bernathtamas/KG-cso-tarto/assets/video-poster.jpg

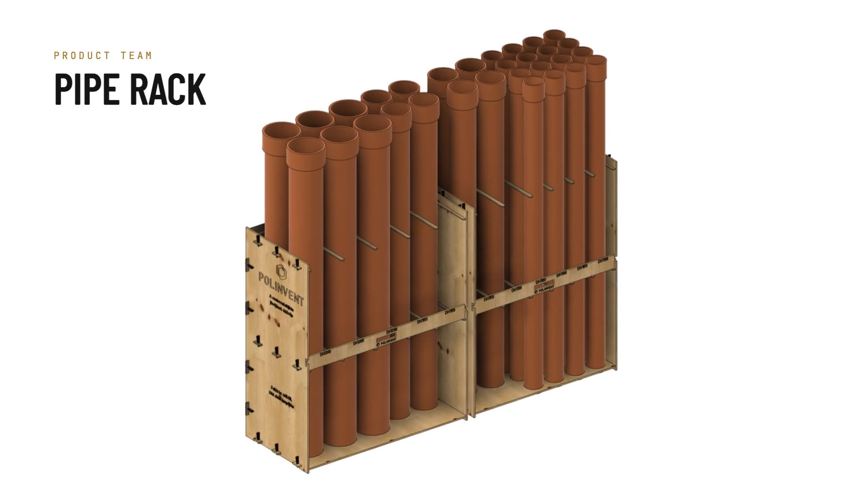
assets/video-poster.jpg
