bernathtamas/KG-cso-tarto/assets/kepek/reszlet_fesu_ek.jpg

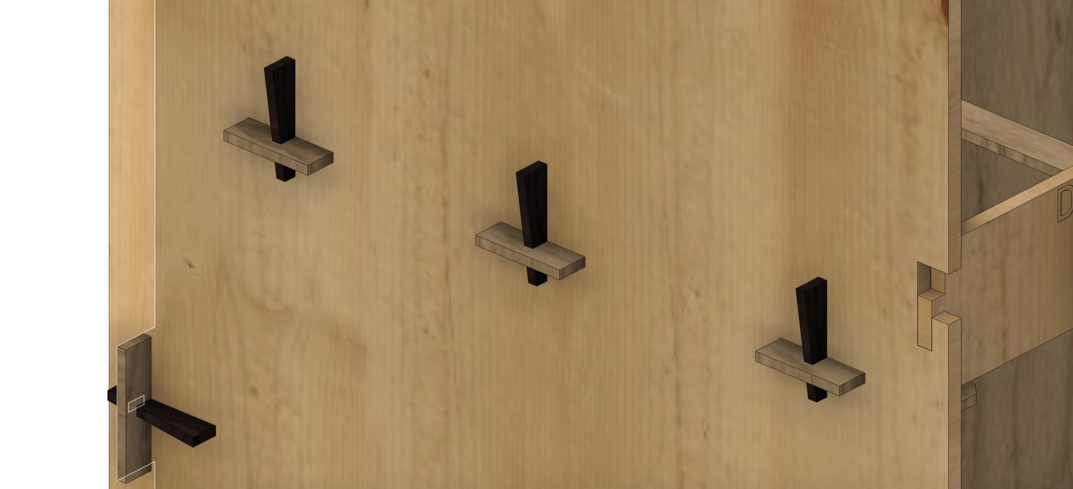
assets/kepek/reszlet_fesu_ek.jpg
