bernathtamas/KG-cso-tarto/assets/elonezet/osszeallitas_3d.png

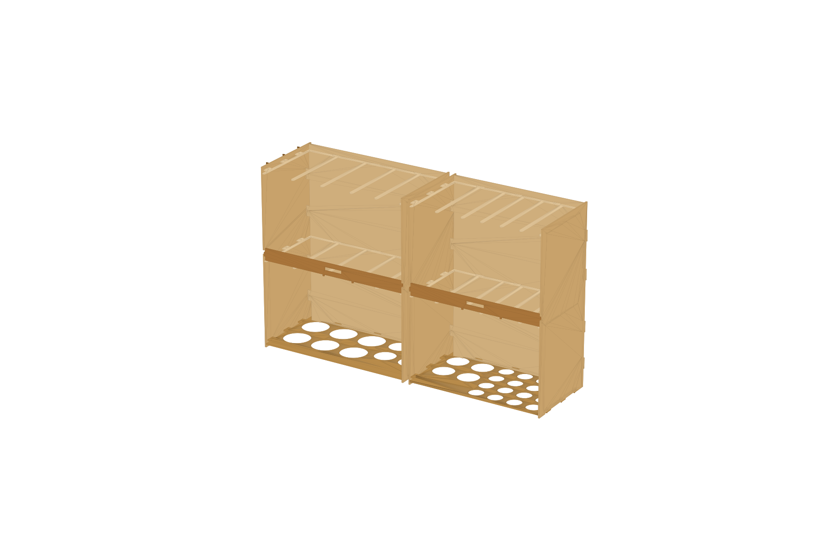
assets/elonezet/osszeallitas_3d.png
