bernathtamas/KG-cso-tarto/assets/elonezet/osszeallitas_csovekkel_3d.png

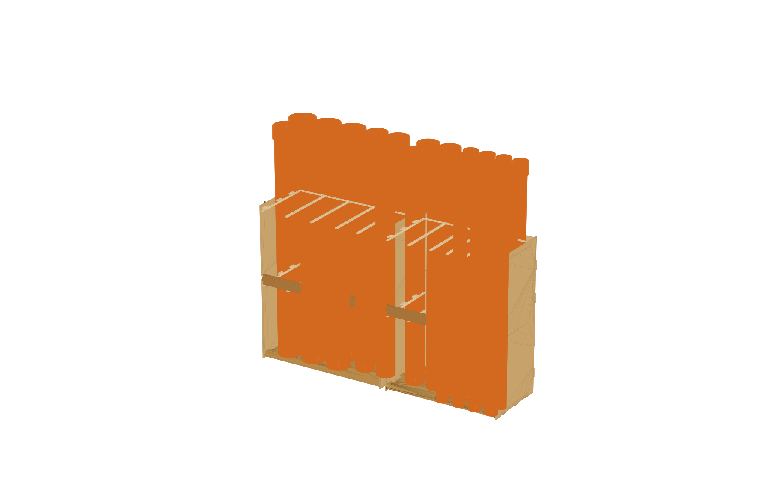
assets/elonezet/osszeallitas_csovekkel_3d.png
