bernathtamas/KG-cso-tarto/assets/elonezet/tabla_01_10mm.png

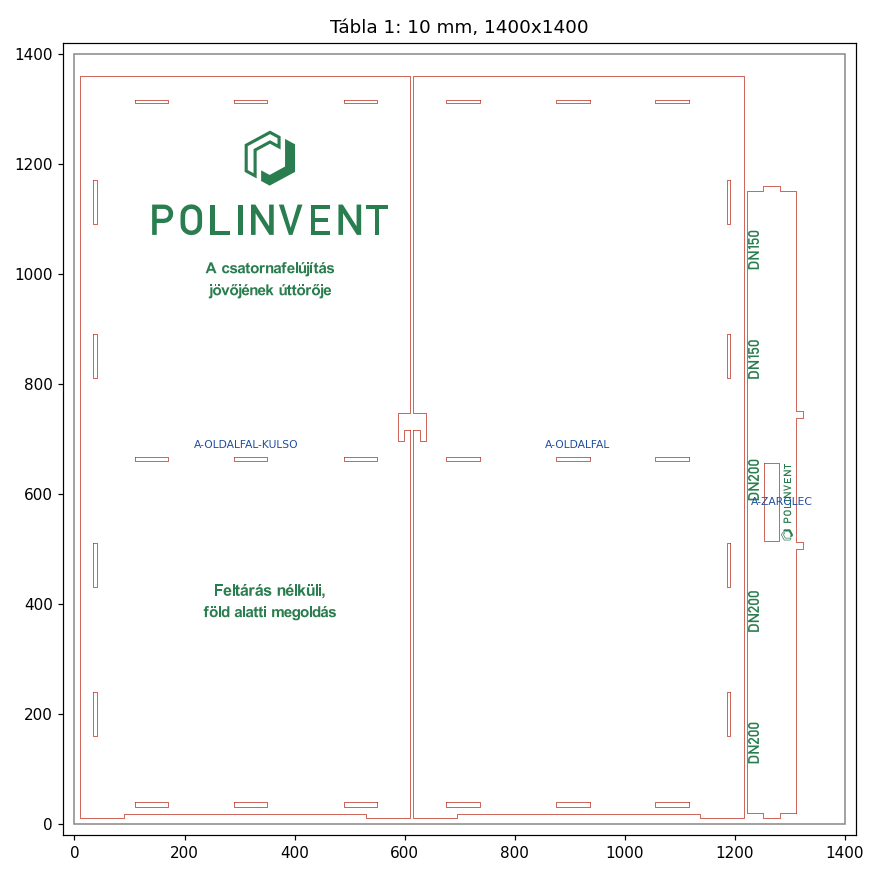
assets/elonezet/tabla_01_10mm.png
