bernathtamas/KG-cso-tarto/assets/elonezet/tabla_02_10mm.png

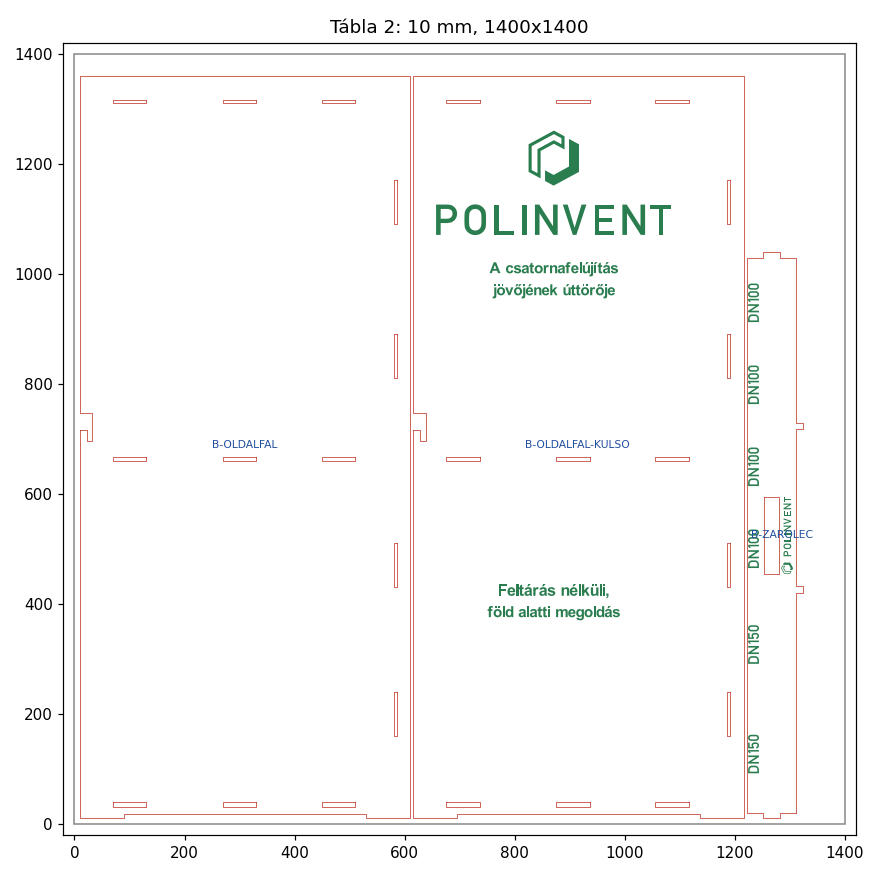
assets/elonezet/tabla_02_10mm.png
