bernathtamas/KG-cso-tarto/assets/elonezet/tabla_03_10mm.png

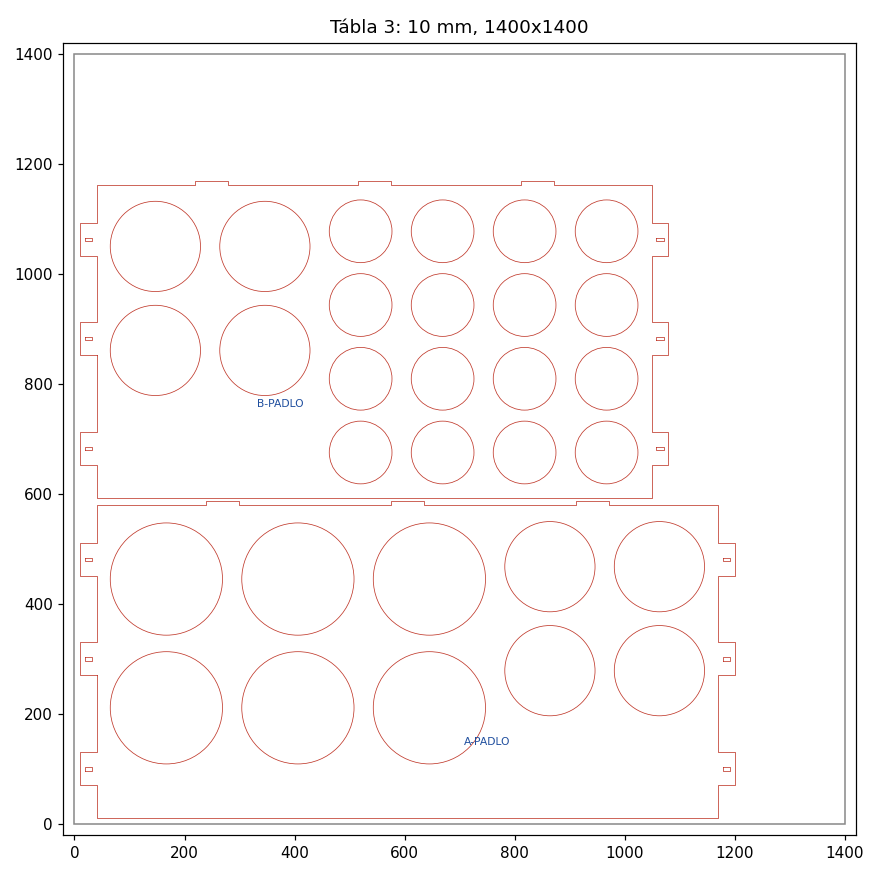
assets/elonezet/tabla_03_10mm.png
