bernathtamas/KG-cso-tarto/assets/elonezet/tabla_04_6mm.png

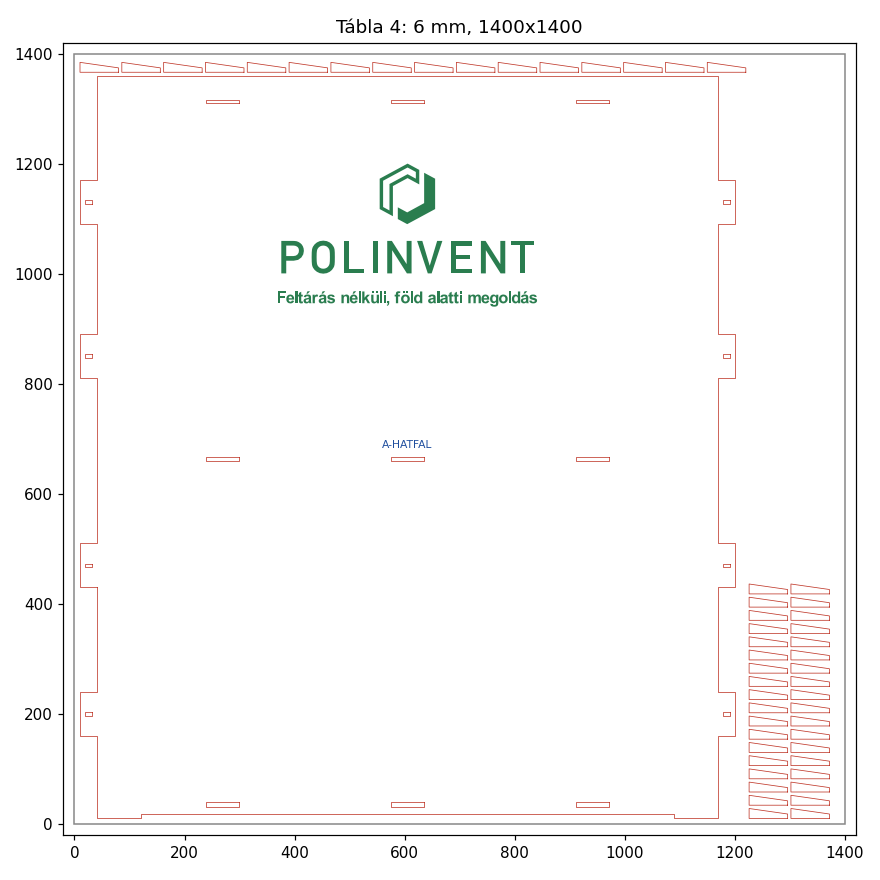
assets/elonezet/tabla_04_6mm.png
