bernathtamas/KG-cso-tarto/assets/elonezet/tabla_05_6mm.png

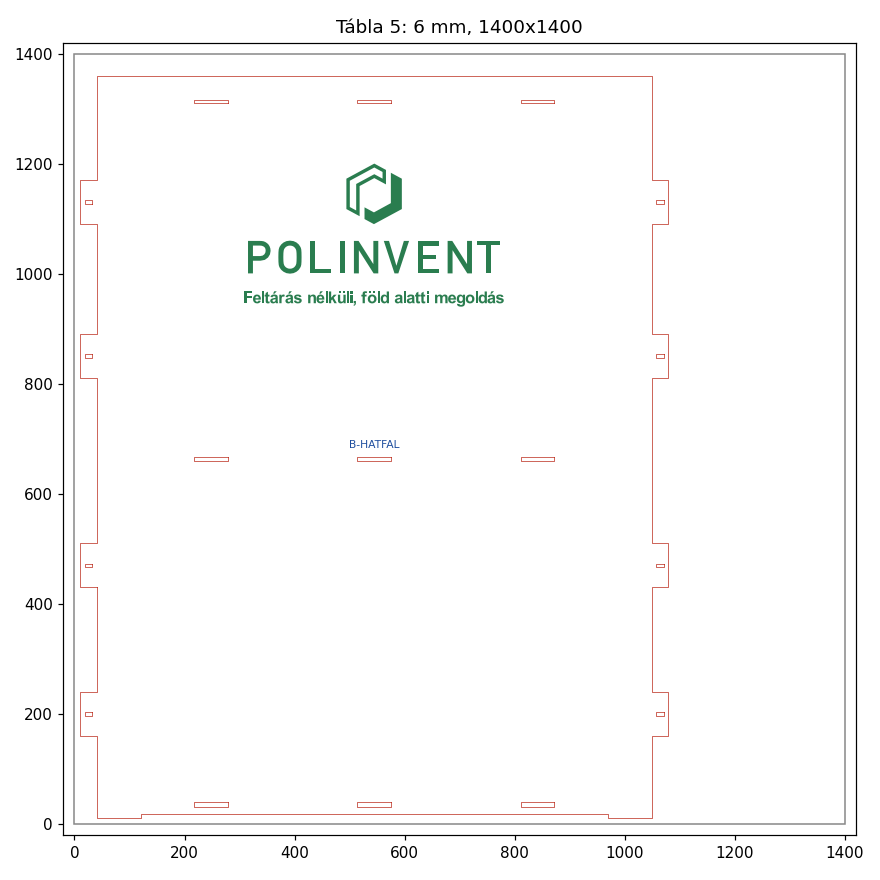
assets/elonezet/tabla_05_6mm.png
