bernathtamas/KG-cso-tarto/assets/elonezet/tabla_06_6mm.png

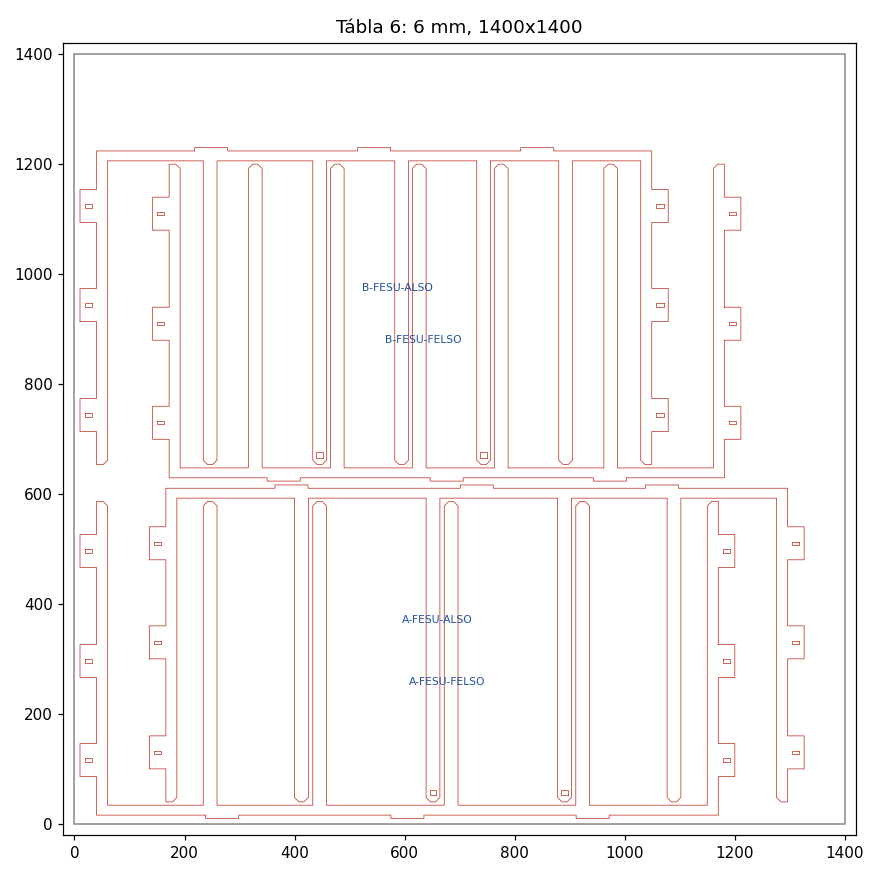
assets/elonezet/tabla_06_6mm.png
