bernathtamas/KG-cso-tarto/assets/kepek/osszeallitas.jpg

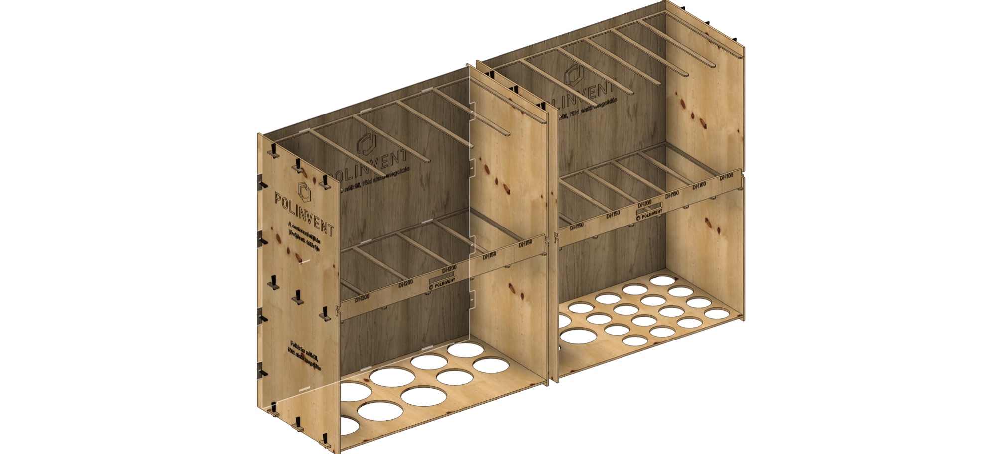
assets/kepek/osszeallitas.jpg
