bernathtamas/KG-cso-tarto/assets/kepek/osszeallitas_csovekkel.jpg

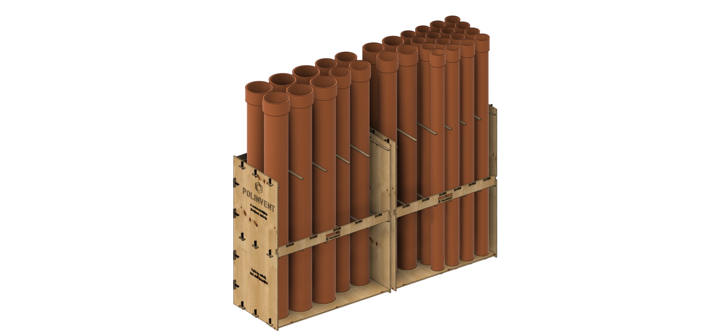
assets/kepek/osszeallitas_csovekkel.jpg
