bernathtamas/KG-cso-tarto/assets/kepek/rajz_2_osszeallitas.jpg

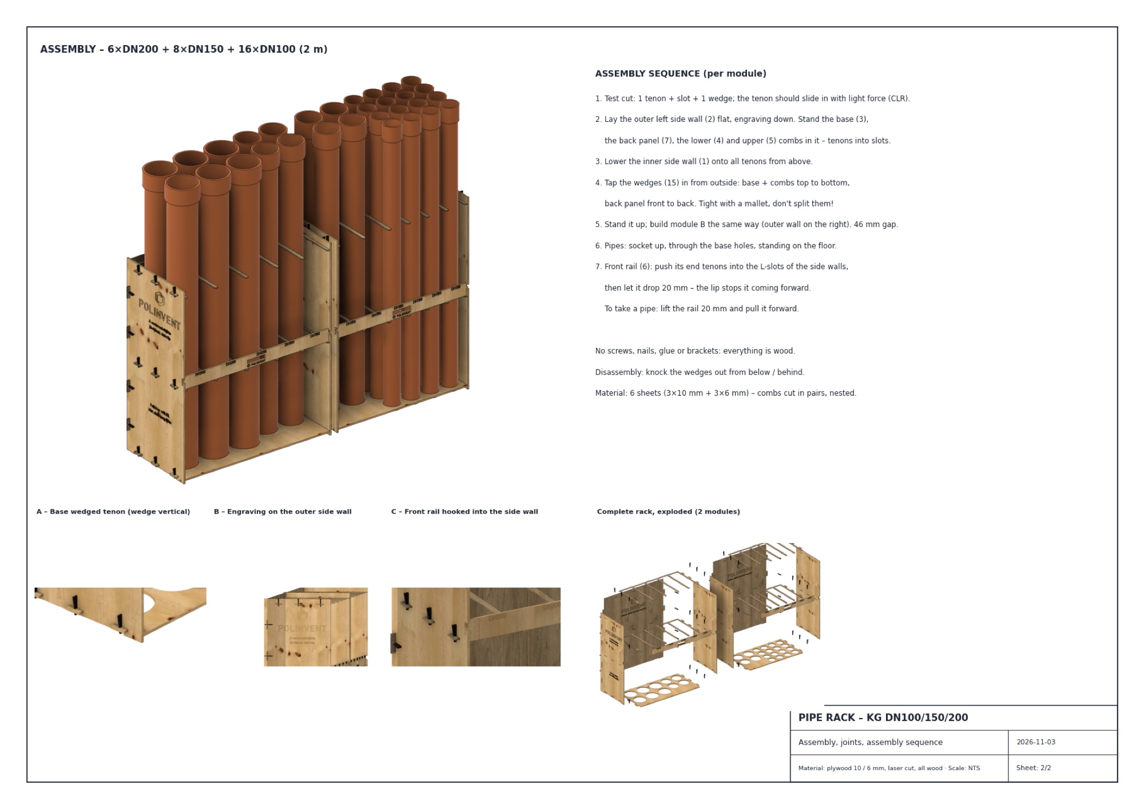
assets/kepek/rajz_2_osszeallitas.jpg
