bernathtamas/KG-cso-tarto/assets/kepek/reszlet_gravir.jpg

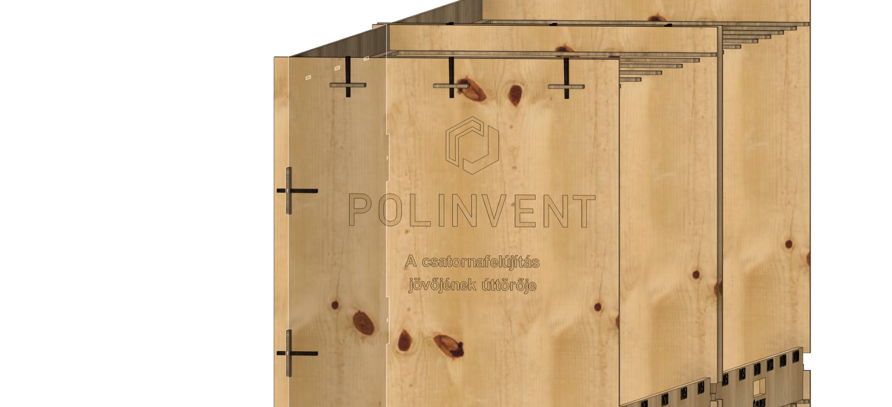
assets/kepek/reszlet_gravir.jpg
