bernathtamas/KG-cso-tarto/assets/kepek/reszlet_hatfal_ek.jpg

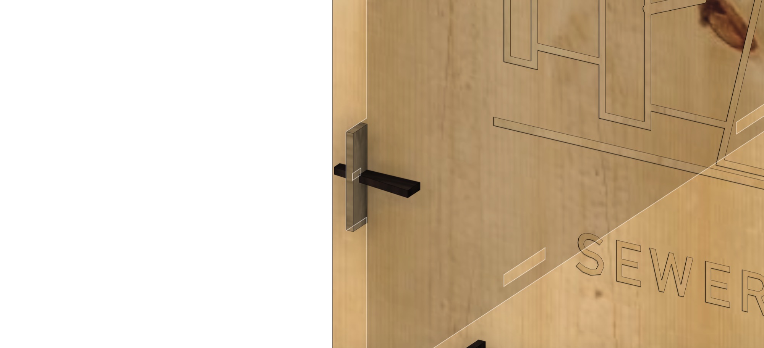
assets/kepek/reszlet_hatfal_ek.jpg
