bernathtamas/KG-cso-tarto/assets/kepek/reszlet_padlo_ek.jpg

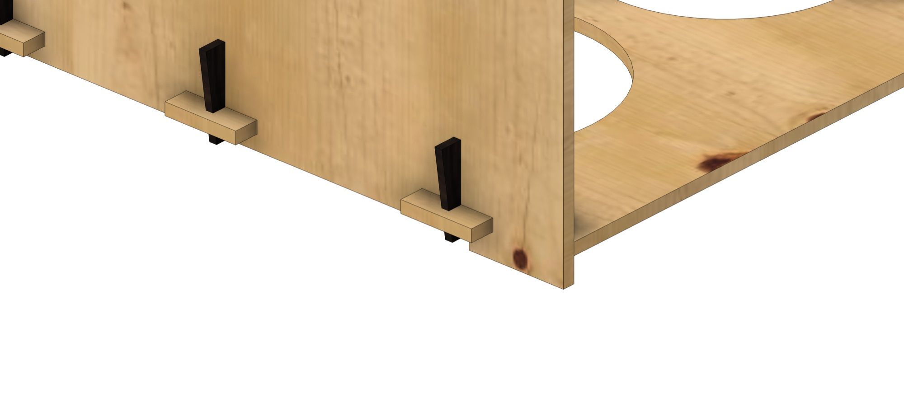
assets/kepek/reszlet_padlo_ek.jpg
