bernathtamas/KG-cso-tarto/assets/kepek/reszlet_zarolec.jpg

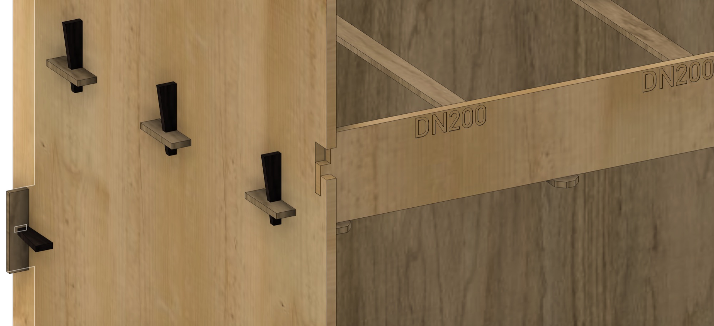
assets/kepek/reszlet_zarolec.jpg
