bernathtamas/KG-cso-tarto/assets/kepek/robbantott_A.jpg

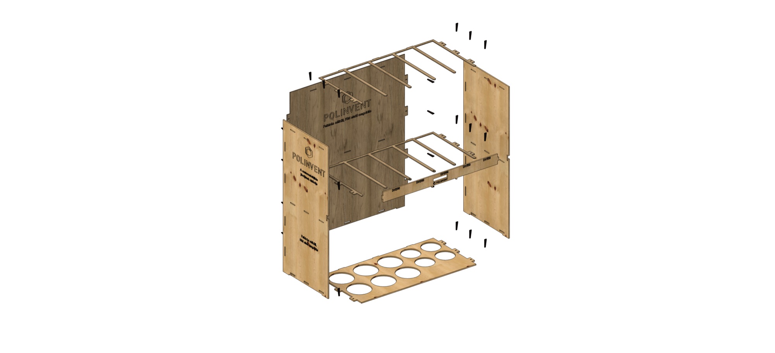
assets/kepek/robbantott_A.jpg
