bernathtamas/KG-cso-tarto/assets/kepek/robbantott_teljes.jpg

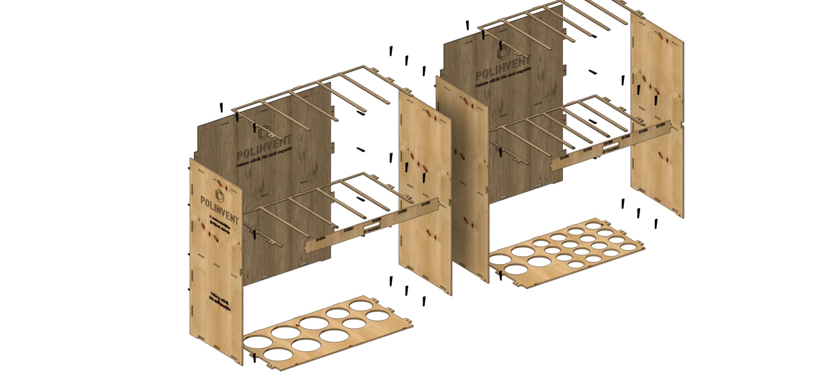
assets/kepek/robbantott_teljes.jpg
