bernathtamas/KG-cso-tarto/assets/sponsors/trudi-bar.webp

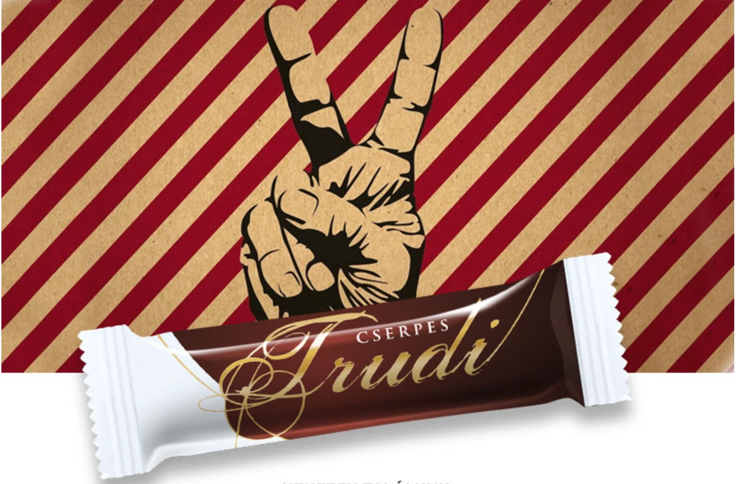
assets/sponsors/trudi-bar.webp
