bernathtamas/KG-cso-tarto/assets/sponsors/turo-rudi.webp

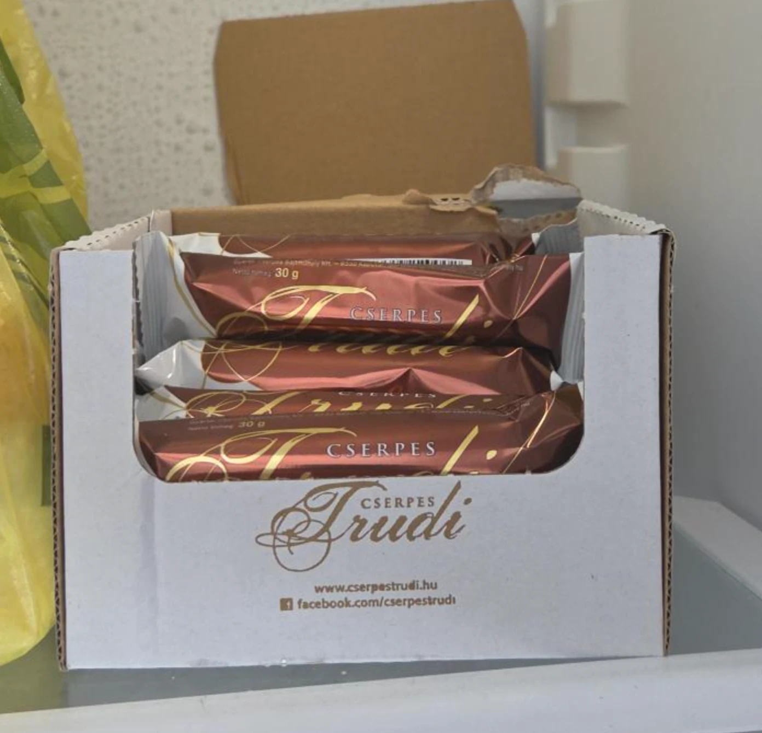
assets/sponsors/turo-rudi.webp
