bernathtamas/KG-cso-tarto/assets/kepek/rajz_1_robbantott_BOM.jpg

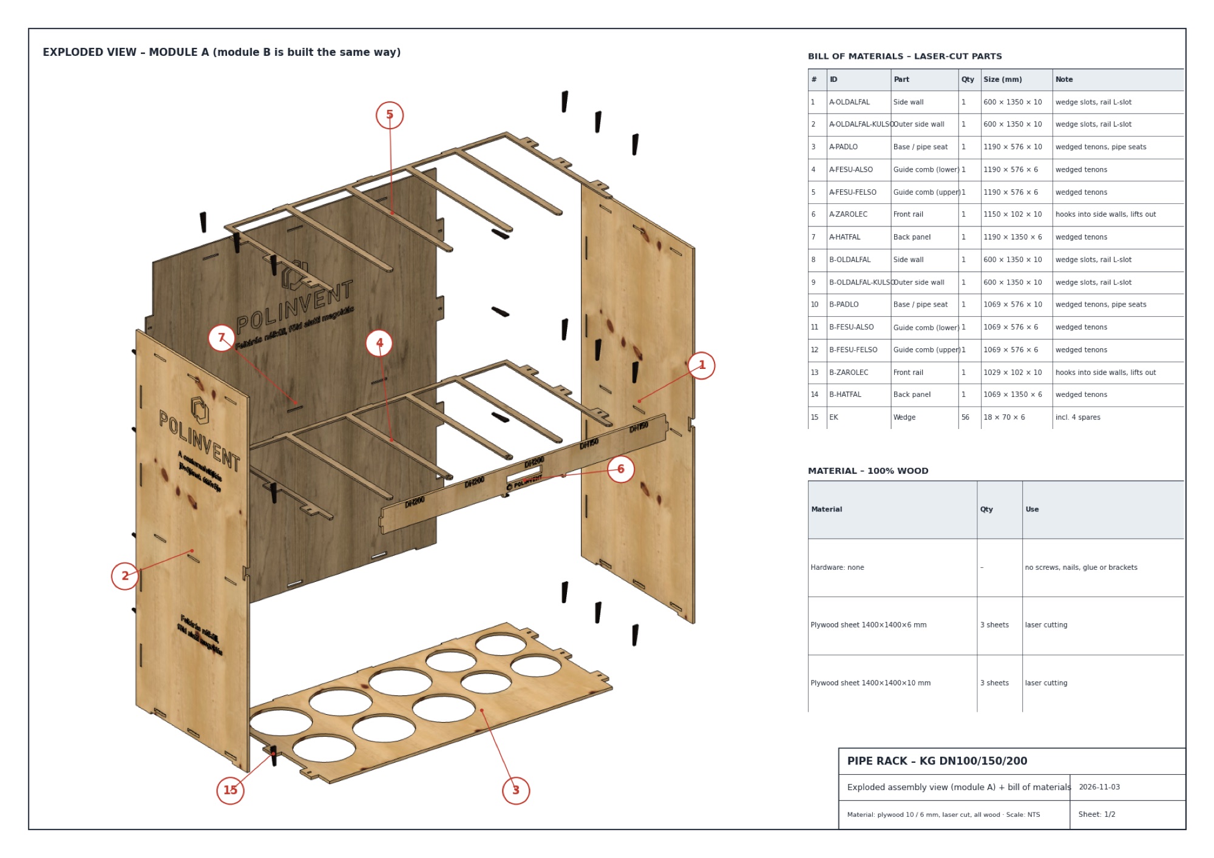
assets/kepek/rajz_1_robbantott_BOM.jpg
