bernathtamas/KG-cso-tarto/assets/model/cso_tarto_V1.step

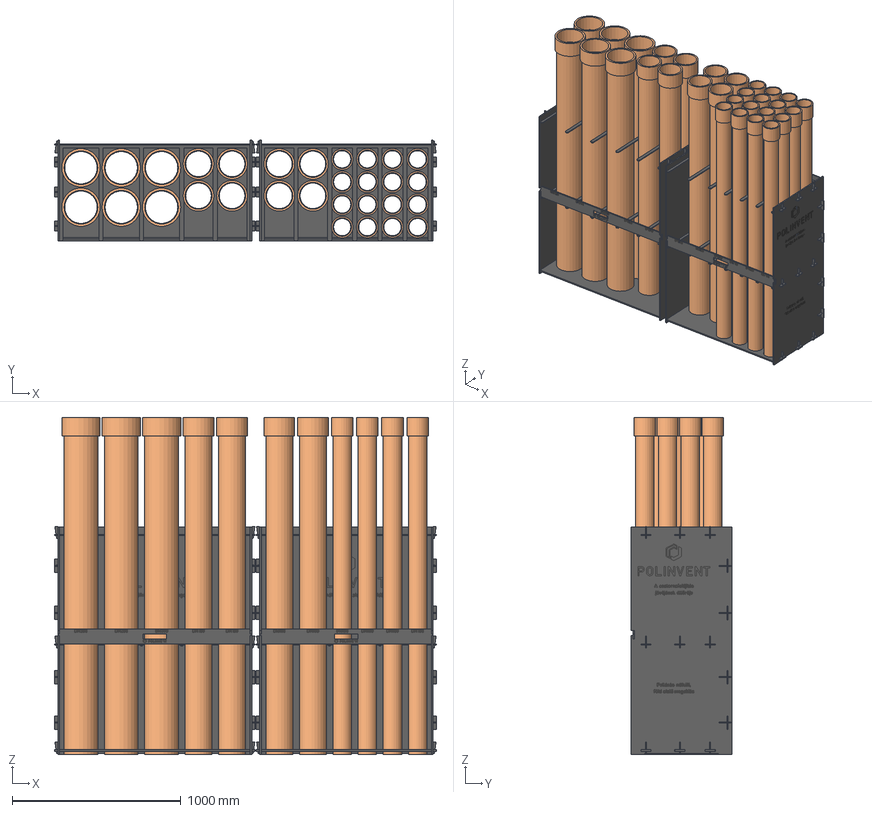
[picture p23: CAD file, 2026-11-03]
assets/model/cso_tarto_V1.step
2265.0 x 600.0 x 2000.0 mm
A-OLDALFAL-KULSO
A-OLDALFAL
A-PADLO
A-FESU-ALSO
A-FESU-FELSO
A-ZAROLEC
A-HATFAL
EK x 52
B-OLDALFAL
B-OLDALFAL-KULSO
B-PADLO
B-FESU-ALSO
B-FESU-FELSO
B-ZAROLEC
B-HATFAL
KGEM DN200 x 6
KGEM DN150 x 8
KGEM DN100 x 16
