bernathtamas/KG-cso-tarto/assets/dxf/tabla_06_6mm.dxf

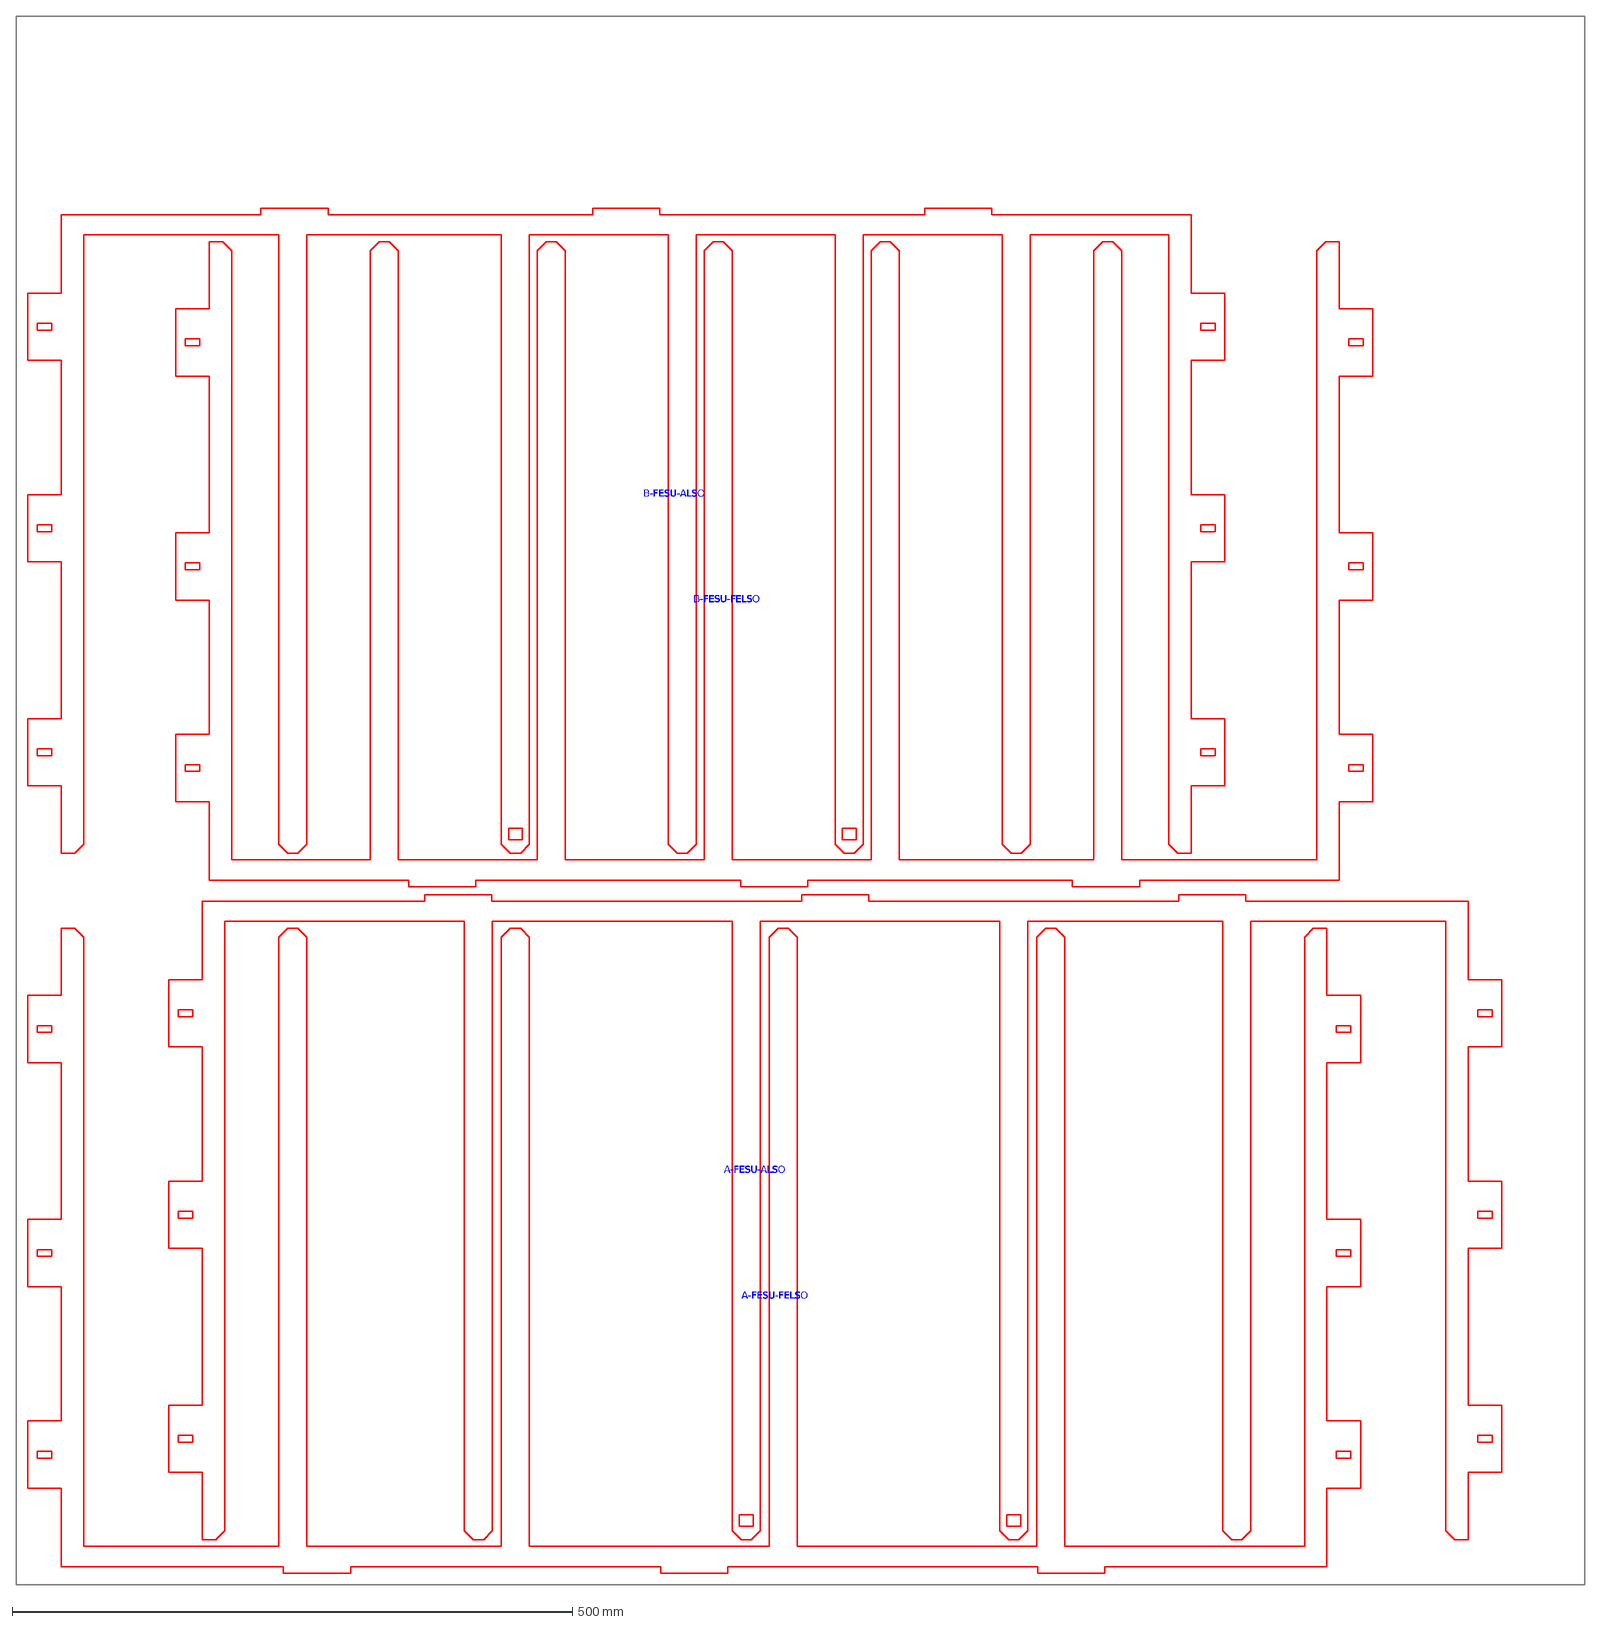
[picture p24: CAD file, 2026-11-03]
assets/dxf/tabla_06_6mm.dxf
A-FESU-ALSO
A-FESU-FELSO
B-FESU-ALSO
B-FESU-FELSO
