bernathtamas/KG-cso-tarto/assets/dxf/tabla_03_10mm.dxf

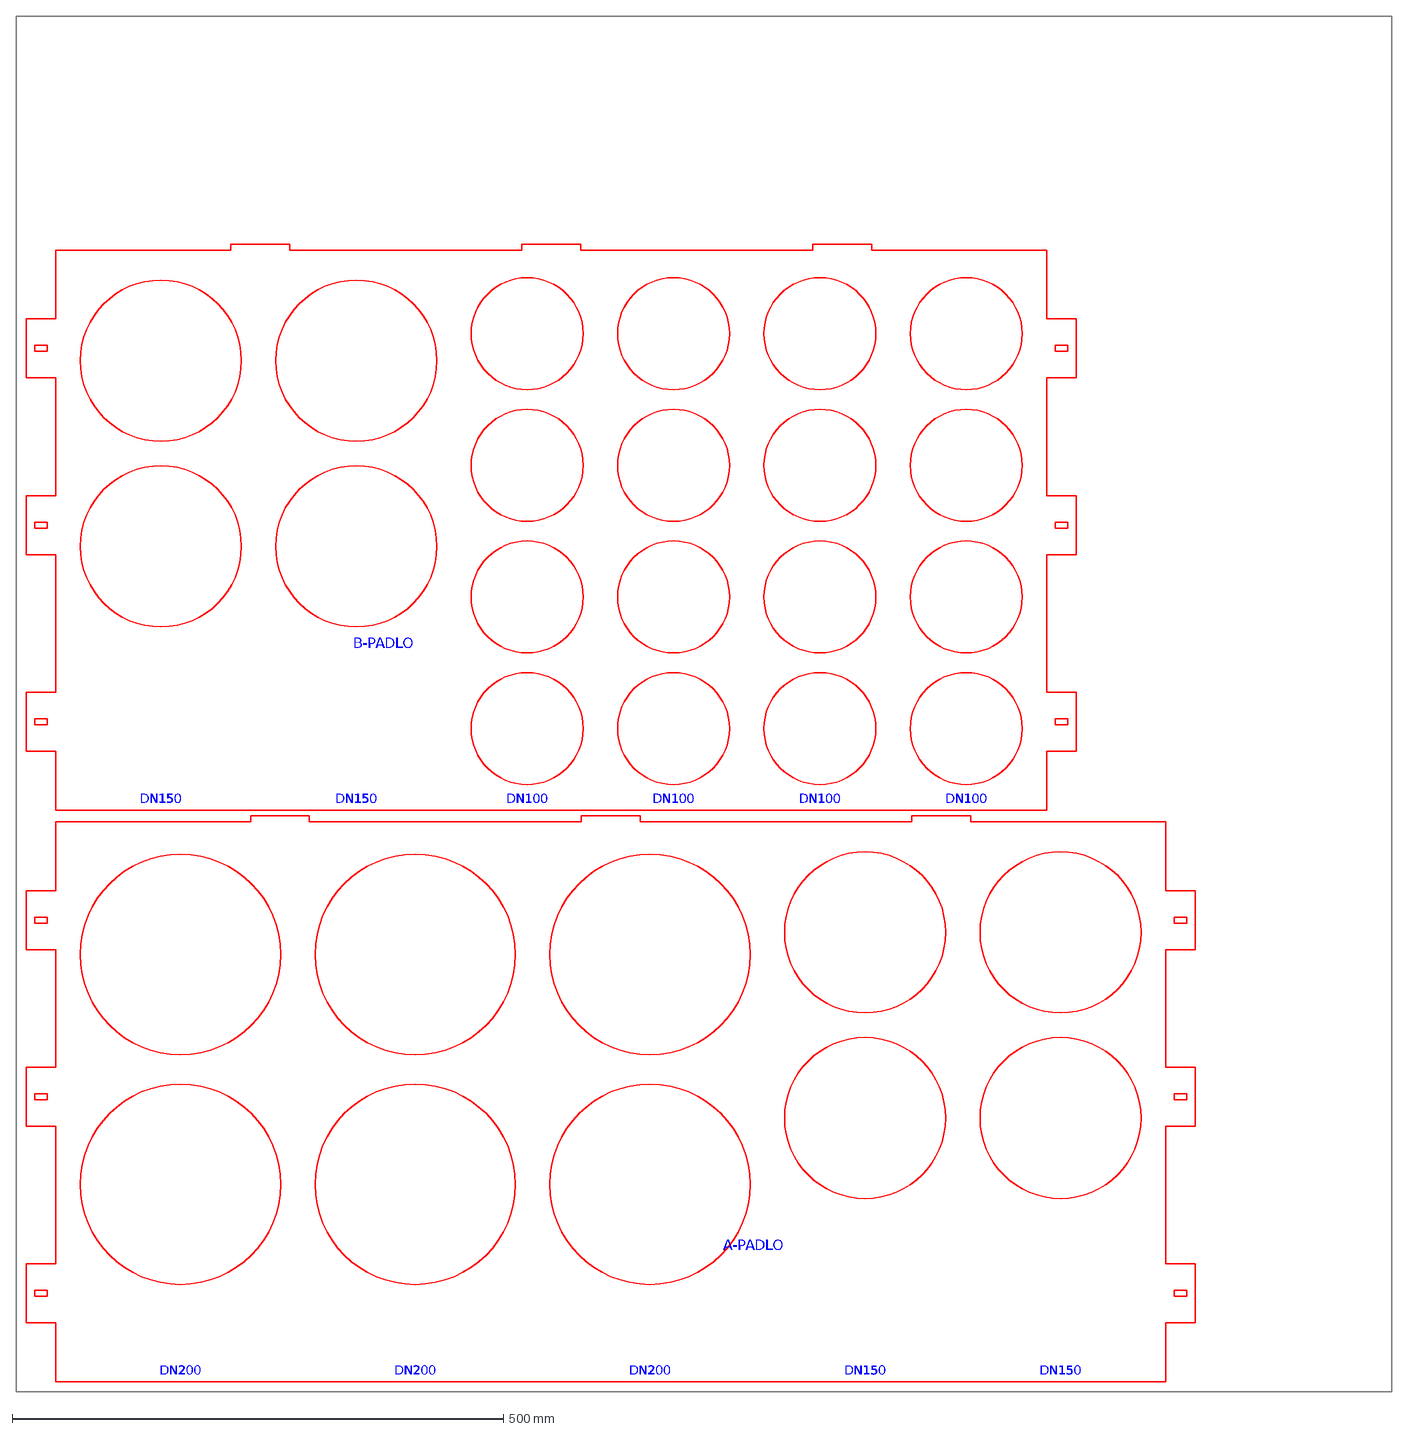
[picture p25: CAD file, 2026-11-03]
assets/dxf/tabla_03_10mm.dxf
DN200
DN150
A-PADLO
DN100
B-PADLO
