bernathtamas/KG-cso-tarto/assets/dxf/tabla_01_10mm.dxf

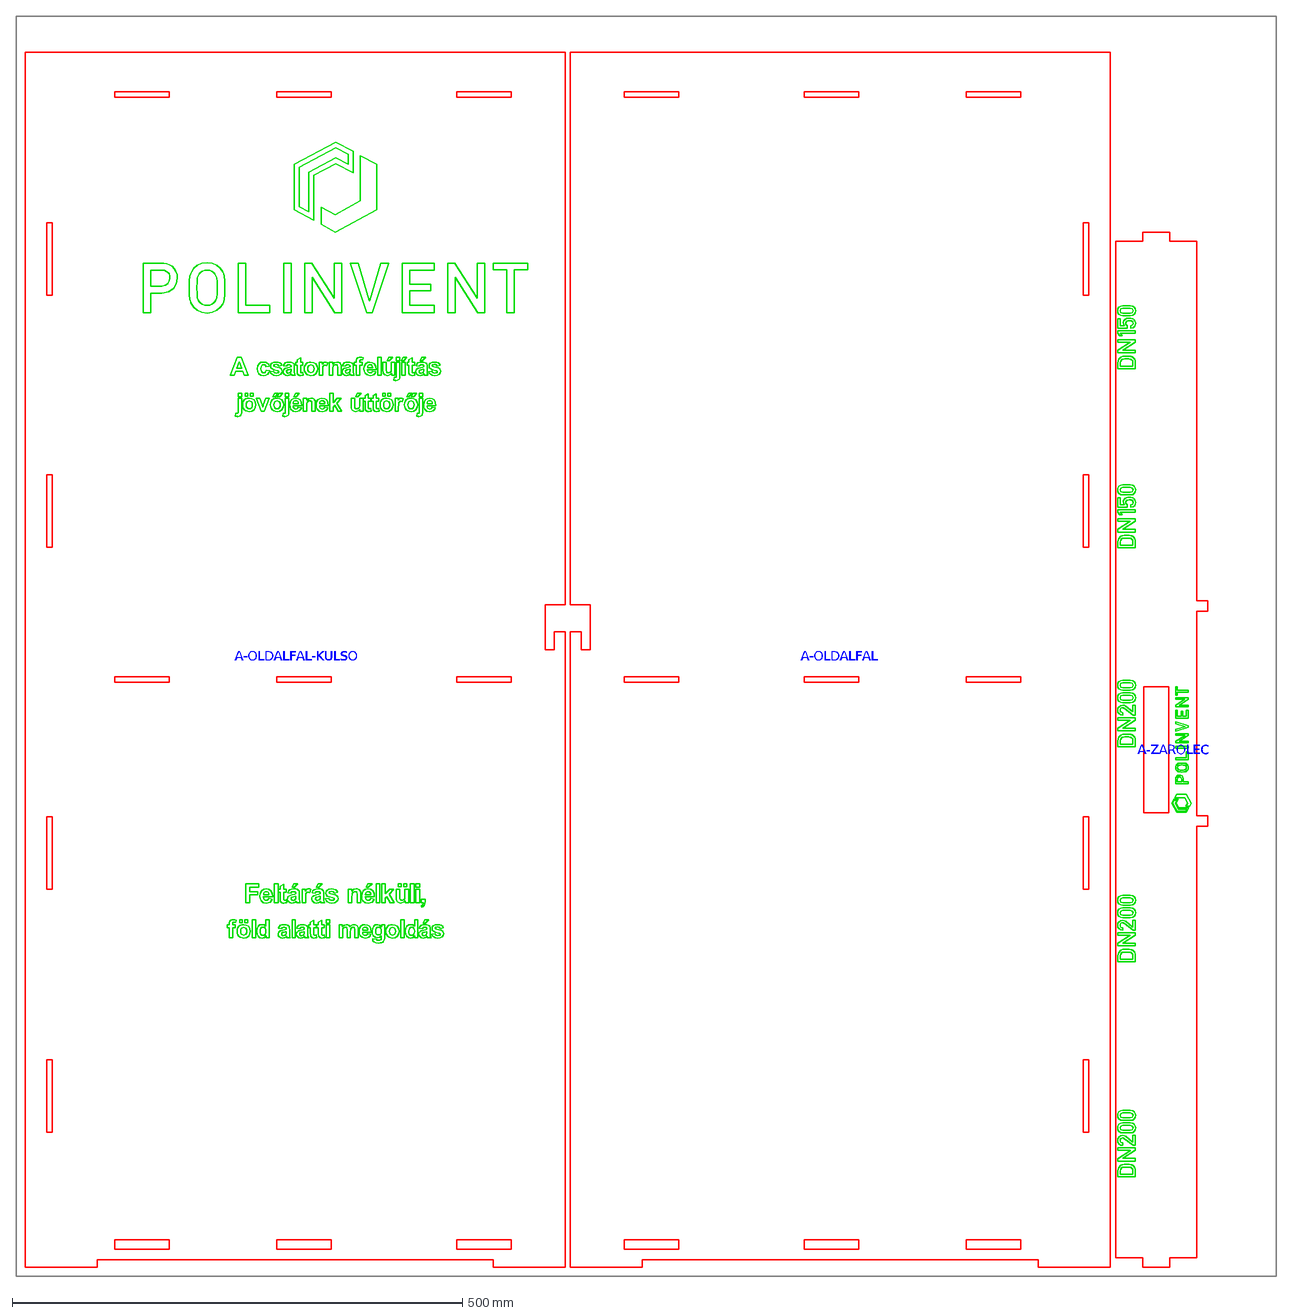
[picture p26: CAD file, 2026-11-03]
assets/dxf/tabla_01_10mm.dxf
A-OLDALFAL-KULSO
A-OLDALFAL
A-ZAROLEC
