bernathtamas/KG-cso-tarto/assets/dxf/tabla_05_6mm.dxf

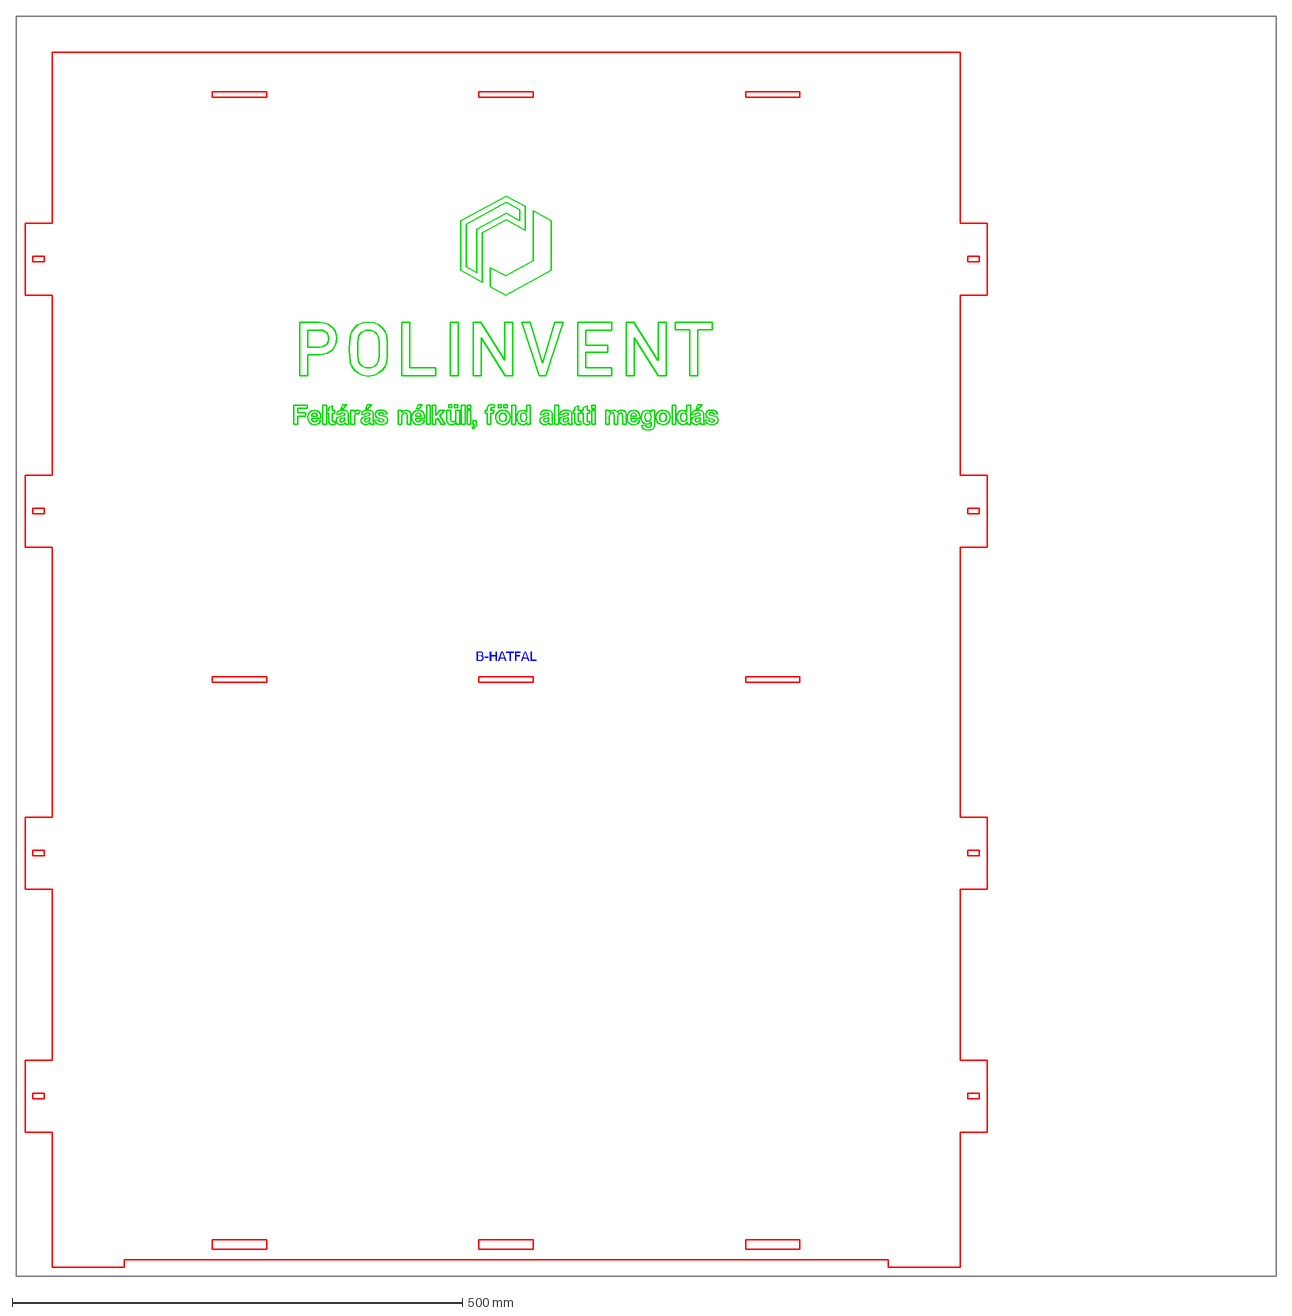
[picture p27: CAD file, 2026-11-03]
assets/dxf/tabla_05_6mm.dxf
B-HATFAL
