bernathtamas/KG-cso-tarto/assets/dxf/tabla_02_10mm.dxf

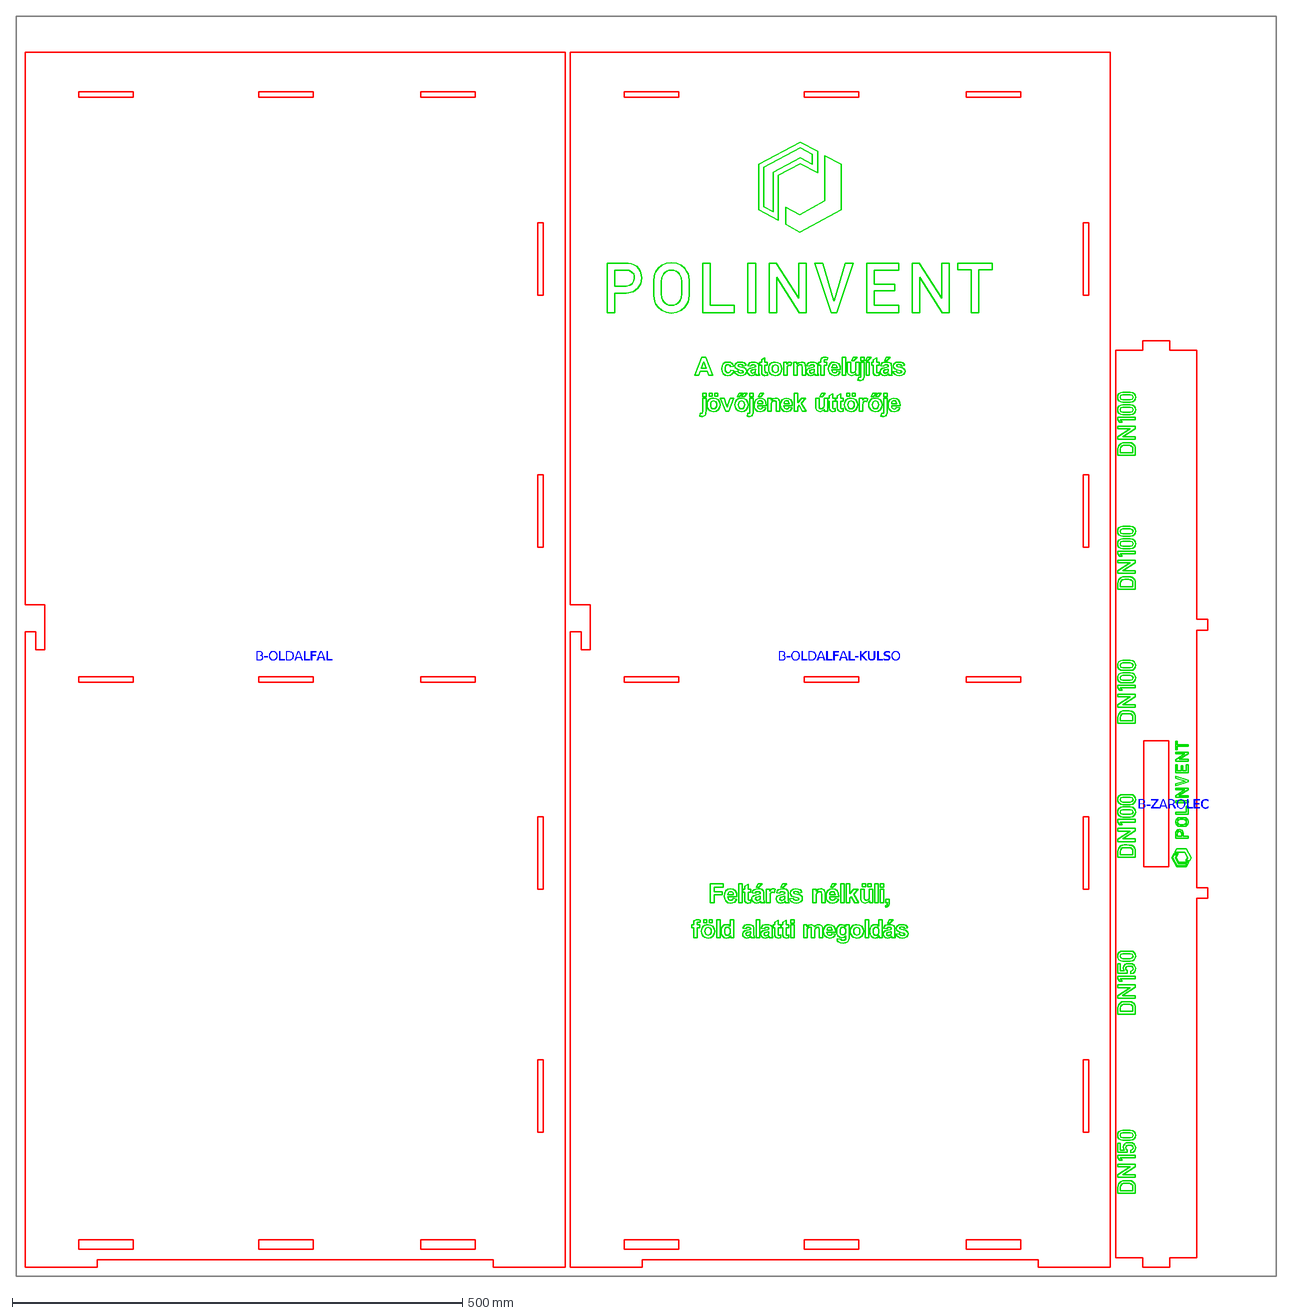
[picture p28: CAD file, 2026-11-03]
assets/dxf/tabla_02_10mm.dxf
B-OLDALFAL
B-OLDALFAL-KULSO
B-ZAROLEC
