bernathtamas/KG-cso-tarto/assets/dxf/tabla_08_6mm.dxf

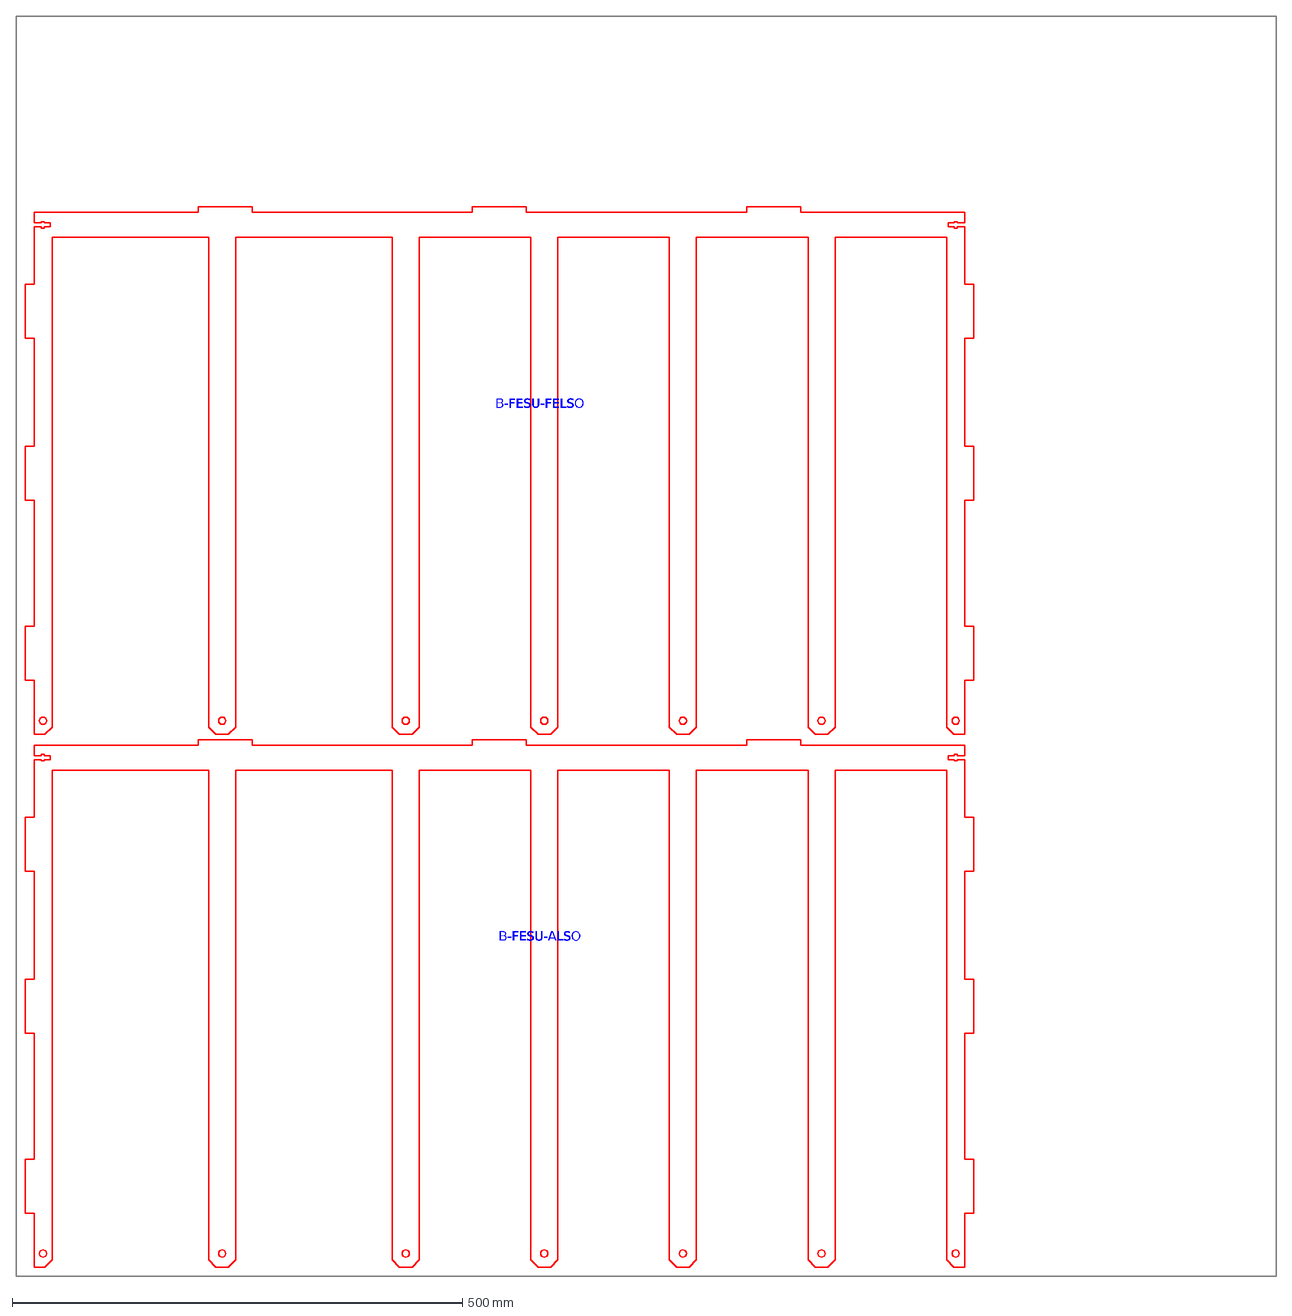
[picture p29: CAD file, 2026-11-03]
assets/dxf/tabla_08_6mm.dxf
B-FESU-ALSO
B-FESU-FELSO
