bernathtamas/KG-cso-tarto/assets/dxf/tabla_07_6mm.dxf

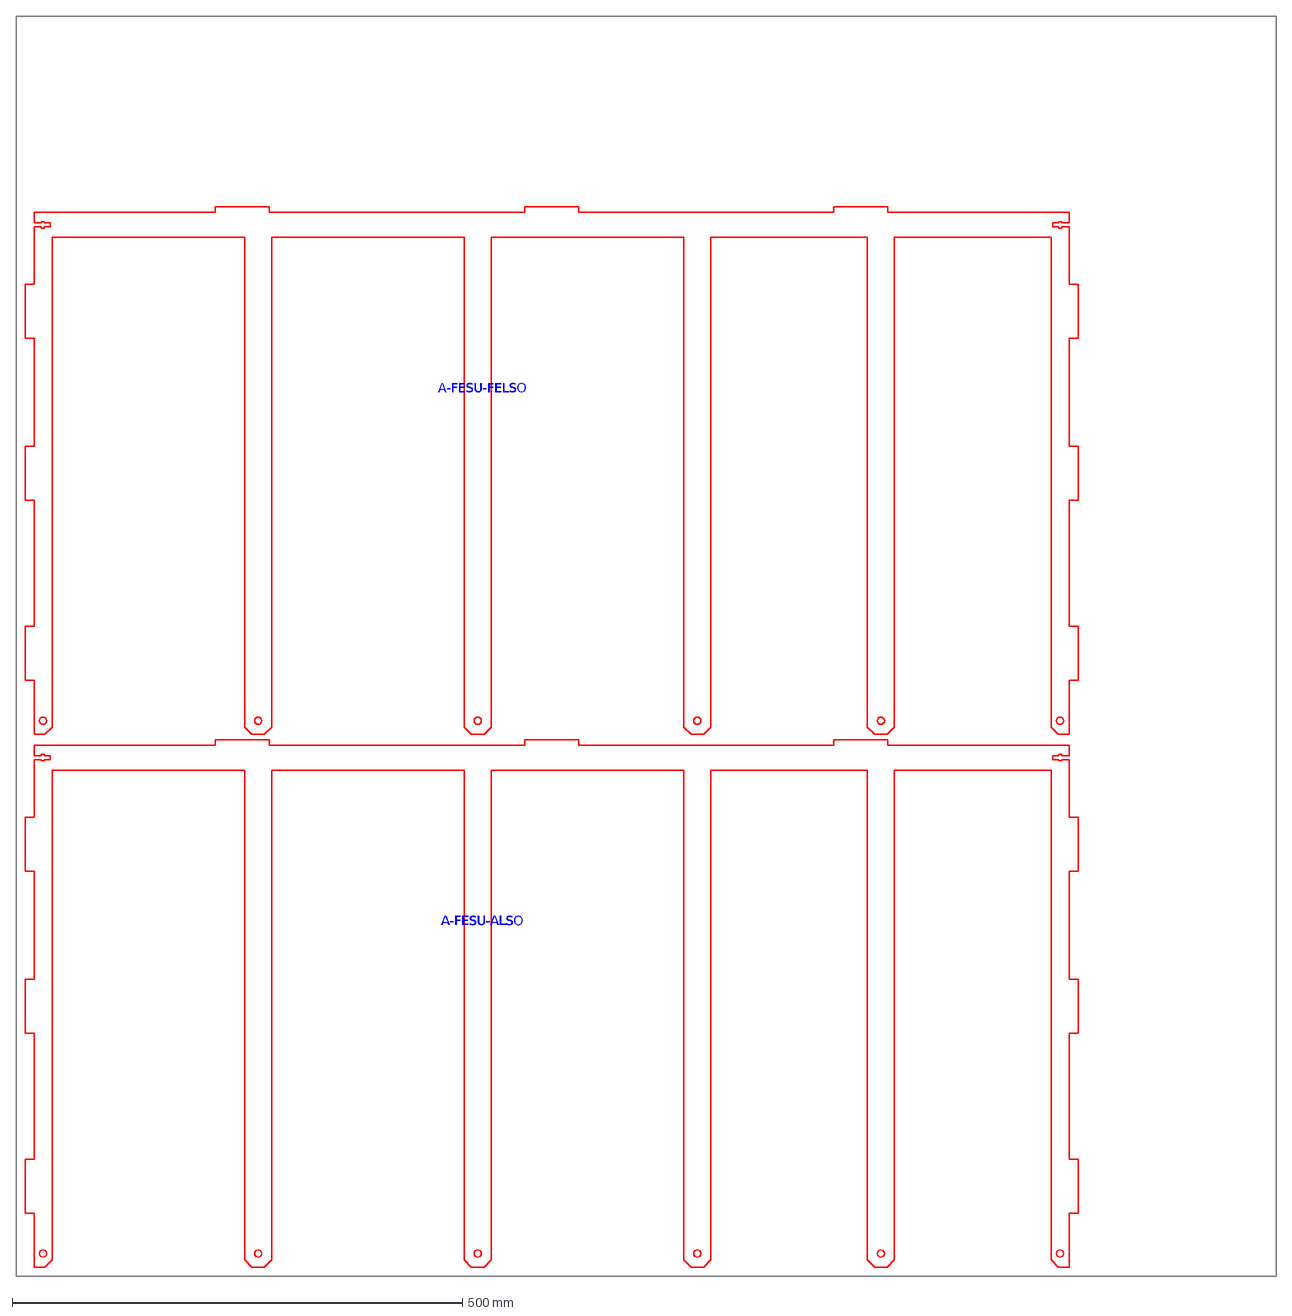
[picture p30: CAD file, 2026-11-03]
assets/dxf/tabla_07_6mm.dxf
A-FESU-ALSO
A-FESU-FELSO
