bernathtamas/KG-cso-tarto/(list of files, cad)

Other CAD files:
assets/dxf/tabla_04_6mm.dxf
assets/dxf/tartalek_ekek_4db_6mm.dxf
