bernathtamas/KG-cso-tarto/assets/dok/Cso_tarto_V1_szerelesi_rajz.pdf

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

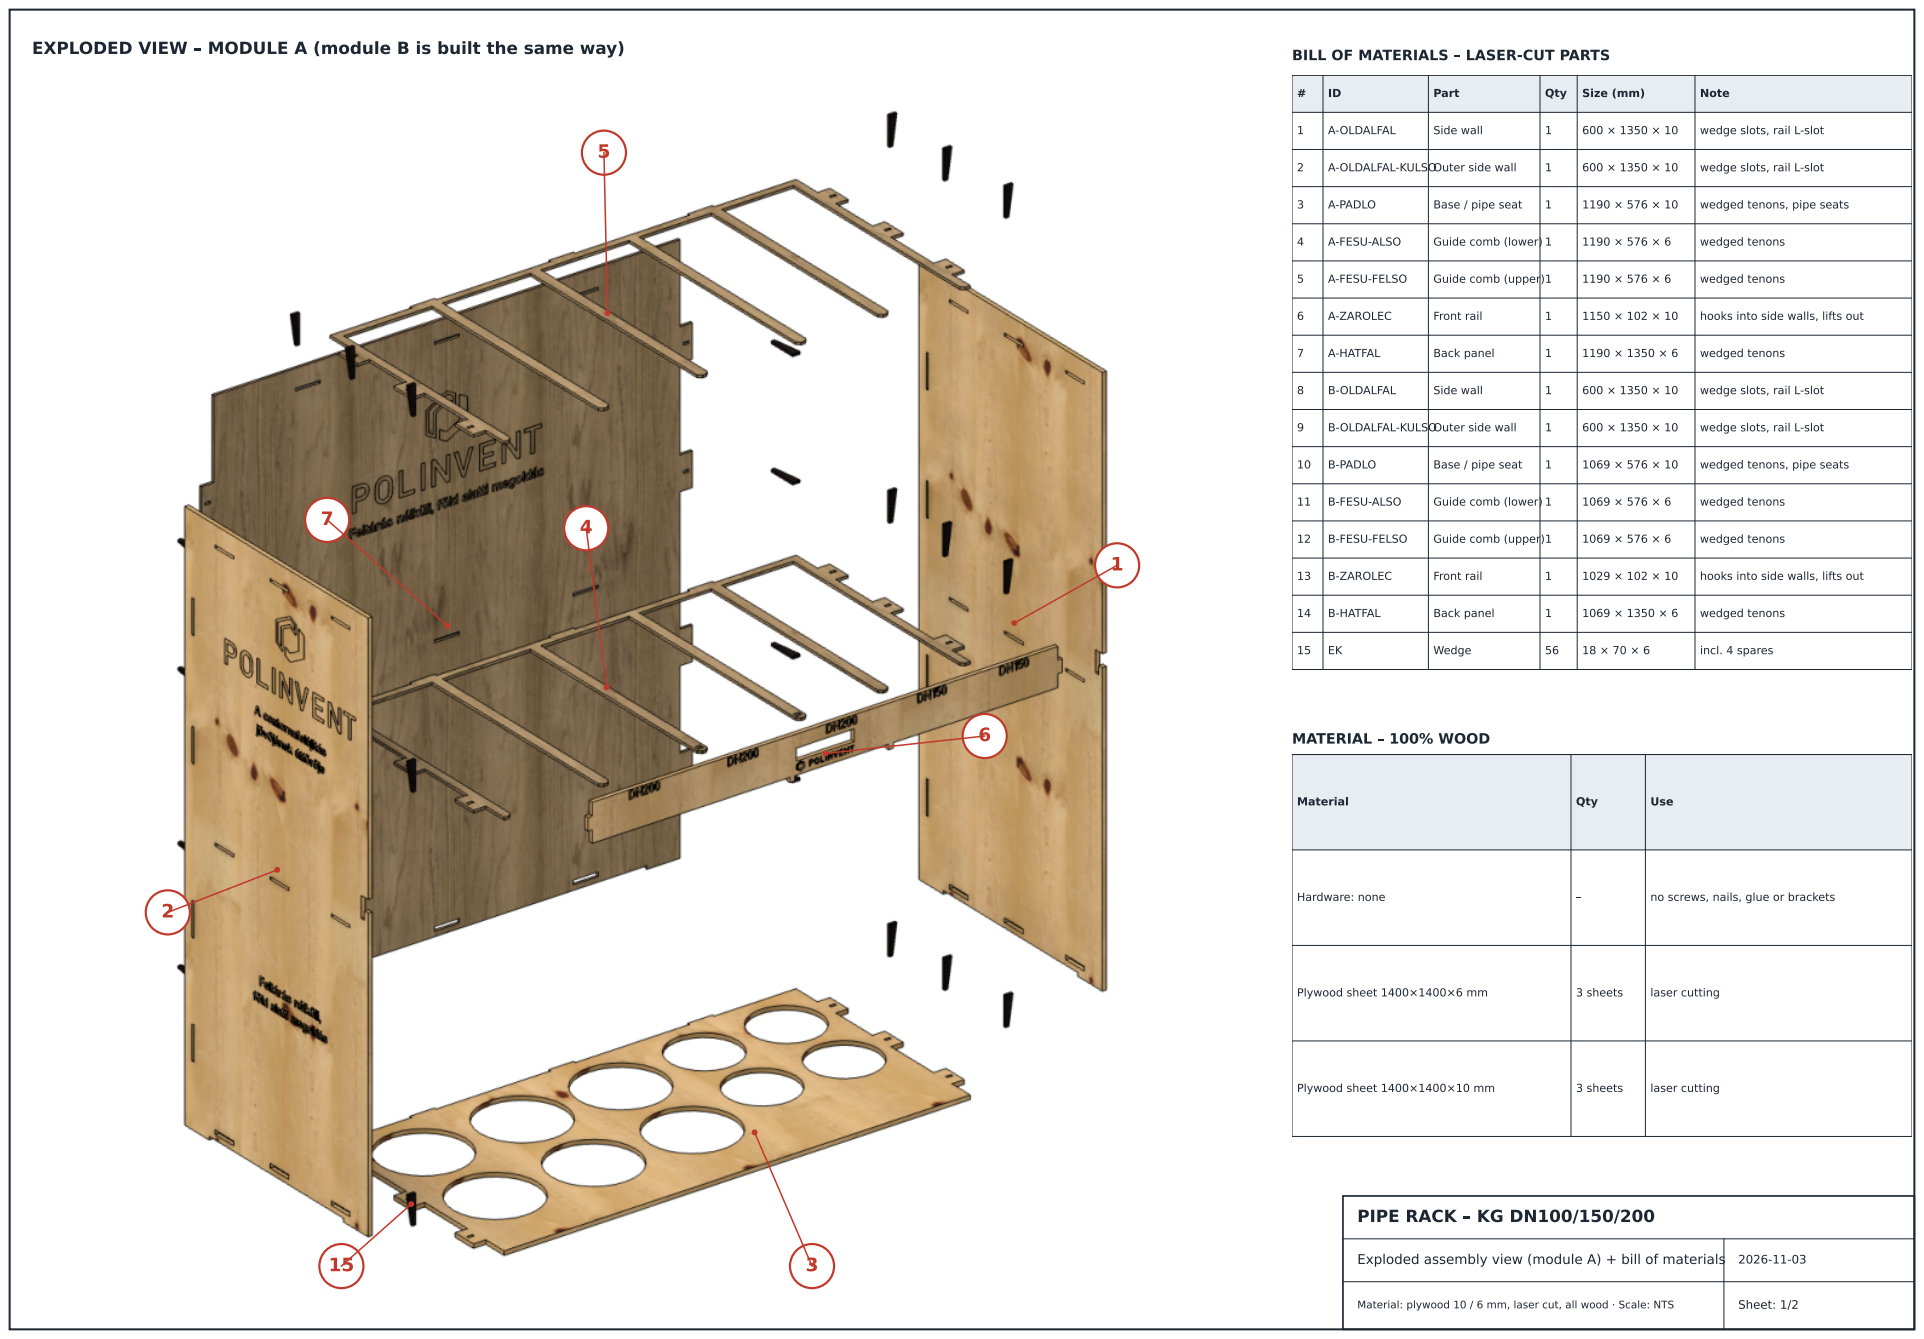
[picture p31: page 1]

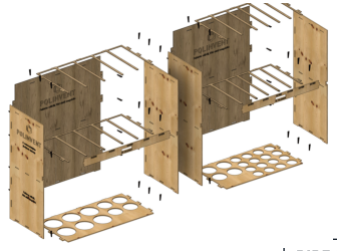
[picture p32: figure]

PIPE RACK | KG DN100/150/200
Assembly, joints, assembly sequence | 2026-11-03
Material: plywood 10 / 6 mm, laser cut, all wood · Scale: NTS | Sheet: 2/2
ASSEMBLY | 6×DN200 + 8×DN150 + 16×DN100 (2 m)

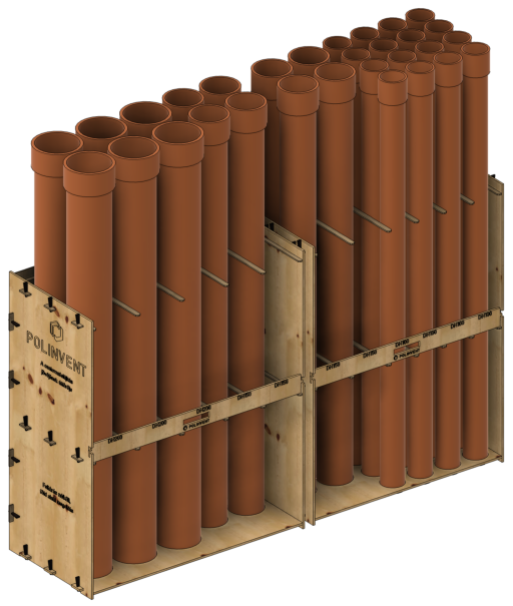
[picture p33: figure]

A | Base wedged tenon (wedge vertical) | B | Engraving on the outer side wall | C | Front rail hooked into the side wall

### ASSEMBLY SEQUENCE (per module)

1. Test cut: 1 tenon + slot + 1 wedge; the tenon should slide in with light force (CLR).
2. Lay the outer left side wall (2) flat, engraving down. Stand the base (3),

the back panel (7), the lower (4) and upper (5) combs in it tenons into slots.

3. Lower the inner side wall (1) onto all tenons from above.
4. Tap the wedges (15) in from outside: base + combs top to bottom,

back panel front to back. Tight with a mallet, don't split them!

5. Stand it up; build module B the same way (outer wall on the right). 46 mm gap.
6. Pipes: socket up, through the base holes, standing on the floor.
7. Front rail (6): push its end tenons into the L-slots of the side walls,

then let it drop 20 mm the lip stops it coming forward.

To take a pipe: lift the rail 20 mm and pull it forward.

No screws, nails, glue or brackets: everything is wood.

Disassembly: knock the wedges out from below / behind.

Material: 6 sheets (3×10 mm + 3×6 mm) combs cut in pairs, nested.

Complete rack, exploded (2 modules)
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
