bernathtamas/KG-cso-tarto/(commit log)

2026-11-03 Product Team weboldal: KG csőtároló V1
    Öt fül (Termékek, Tervezés folyamata, Mellékletek, Út a megvalósításig,
    Rólunk), forgó 3D PT logó, forgatható GLB/STEP modell, BOM, DXF táblák.
    [tabla_01_10mm.dxf, tabla_02_10mm.dxf, tabla_03_10mm.dxf, tabla_04_10mm.dxf, tabla_05_6mm.dxf, tabla_06_6mm.dxf, tabla_07_6mm.dxf, tabla_08_6mm.dxf]
2026-11-03 Frissítés a legújabb modellre: ékes csapok, zároléc, 6 tábla, STEP, BOM, robbantott ábra, csomópontok
    [BOM_cso_tarto_V1.csv, cso_tarto_V1.step, tabla_01_10mm.dxf, tabla_02_10mm.dxf, tabla_03_10mm.dxf, tabla_04_10mm.dxf, tabla_04_6mm.dxf, tabla_05_6mm.dxf]
2026-11-03 V1.1, English site: project log, sponsors, blueprint 3D viewer, all-wood BOM, laser cutting as the only step left
    [BOM_cso_tarto_V1.csv, cso_tarto_V1.step, tabla_01_10mm.dxf, tabla_02_10mm.dxf, tabla_03_10mm.dxf, tabla_04_6mm.dxf, tabla_05_6mm.dxf, tabla_06_6mm.dxf]
2026-11-03 Material use 73% with the new layout
2026-11-03 Video: 73% material use, caption fix
2026-11-03 All-wood model: no nails, glue or brackets; English BOM and assembly drawing; time tracking to 13:21; English README with QR
    [BOM_cso_tarto_V1.csv, pipe_rack_BOM.csv, tabla_01_10mm.dxf, tabla_02_10mm.dxf, tabla_03_10mm.dxf, tabla_04_6mm.dxf, tabla_05_6mm.dxf, tabla_06_6mm.dxf]
2026-11-03 Lift-the-rail demo, explode slider, Túró Rudi easter egg, Pipe Runner game tab
2026-11-03 Pipe Runner: endless, score = pipes, speed tiers by score, screws on platforms
